BhavyaBansal26/ALPANA-SOC/sdk/software/projects/weatherstation/Readme.md

Sample project to demonstrate integration of temperature sensor and transmission of data to a website.
LM75 sensor is used to collect ambient temperature, ESP8266 module is  used to send data to thingspeak.com

Prerequisite:
1. ESP8266 is configured to baud rate 9600
2. ESP8266 is set in station mode
3. ESP8266 is configured to connect to access point.
4. A channel to receive data is configured in thingspeak.com
5. Change the API_key in the weatherstation.c
