BhavyaBansal26/ALPANA-SOC/sdk/software/examples/i2c_applns/ds3231/readme.md

sensor - lm75
peripheral - i2c

<readme to follow>
