BhavyaBansal26/ALPANA-SOC/sdk/software/projects/uart-cam/Connections/Overall.jpeg

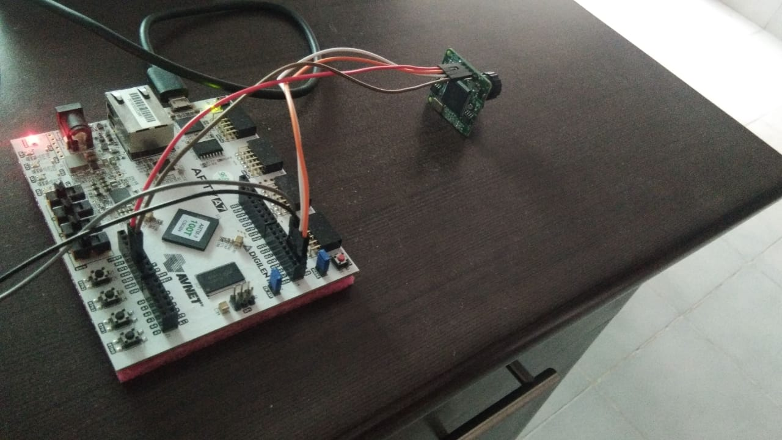
sdk/software/projects/uart-cam/Connections/Overall.jpeg
