BhavyaBansal26/ALPANA-SOC/sdk/software/projects/uart-cam/Connections/UART1&UART2.jpeg

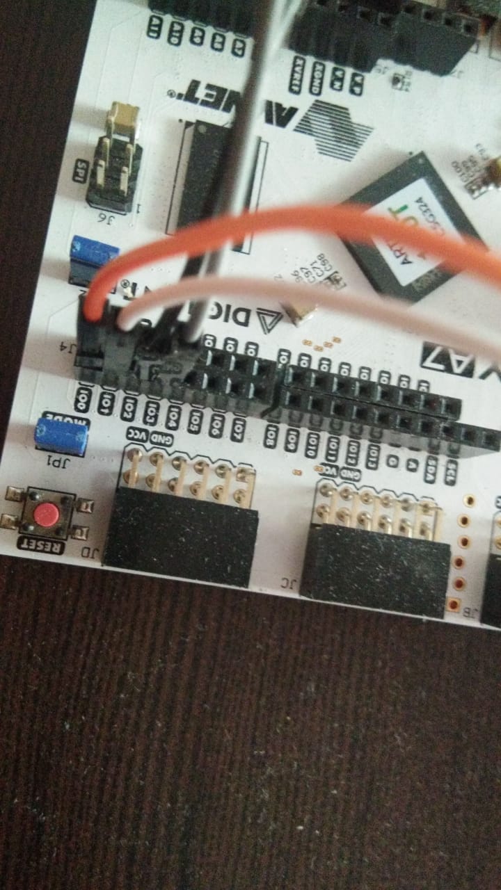
sdk/software/projects/uart-cam/Connections/UART1&UART2.jpeg
