BhavyaBansal26/ALPANA-SOC/sdk/software/projects/uart-cam/Connections/Uart_to_usb.jpeg

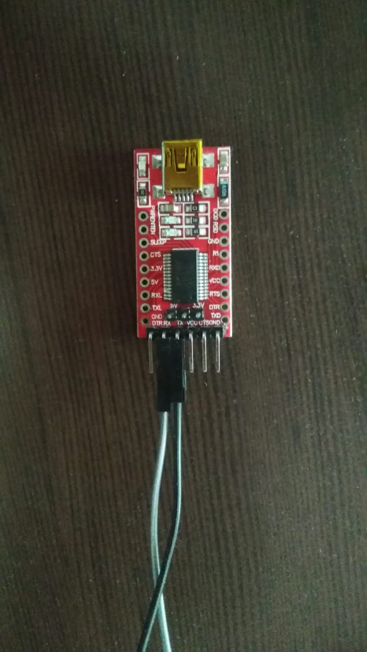
sdk/software/projects/uart-cam/Connections/Uart_to_usb.jpeg
