BhavyaBansal26/ALPANA-SOC/docs/images/esp32cam_lane_wiring.png

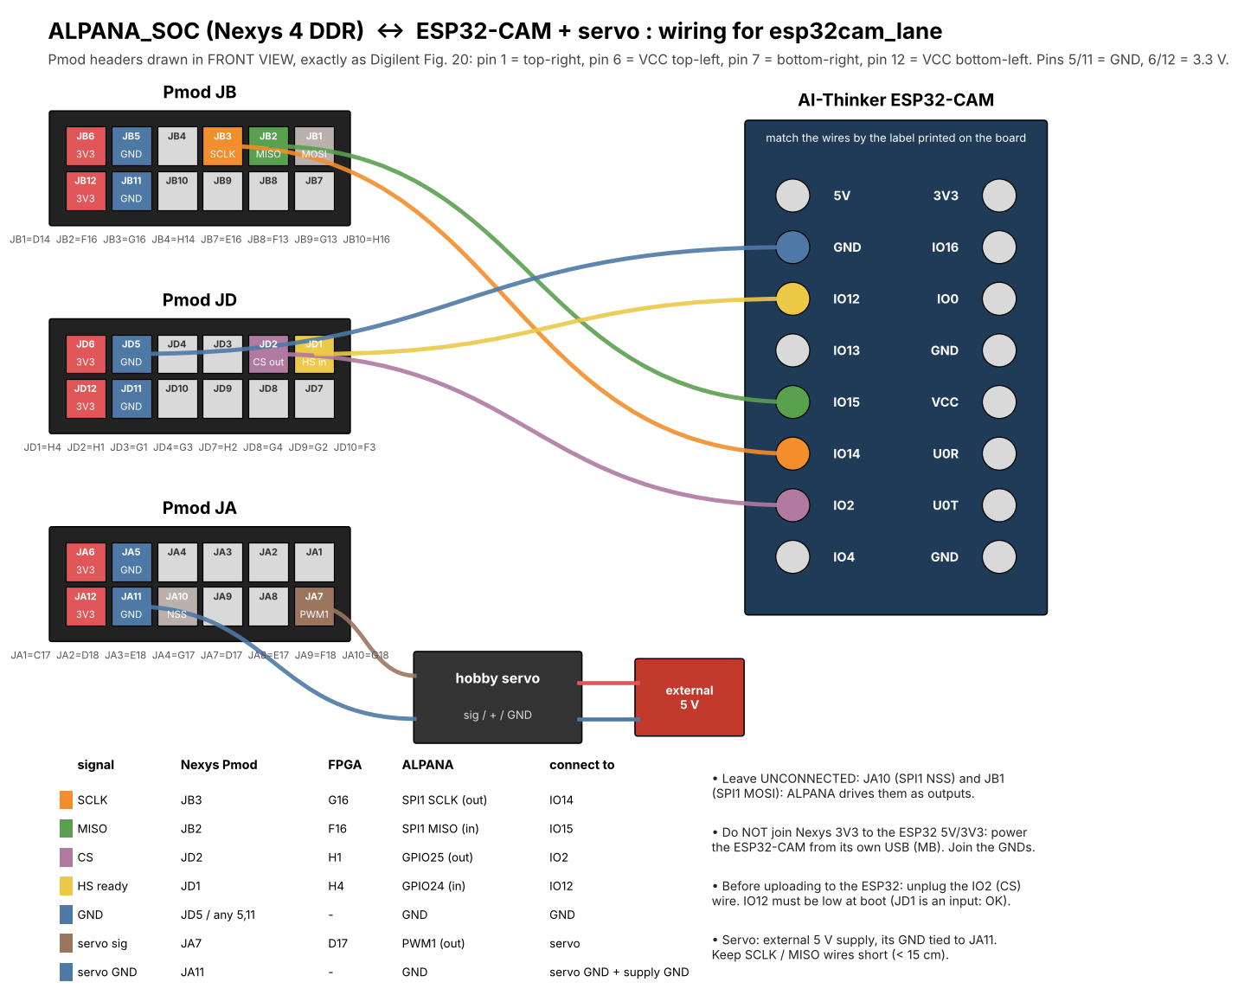
docs/images/esp32cam_lane_wiring.png
