BhavyaBansal26/ALPANA-SOC/sdk/software/examples/alpana_applns/esp32cam_lane/host/lane_test_results.png

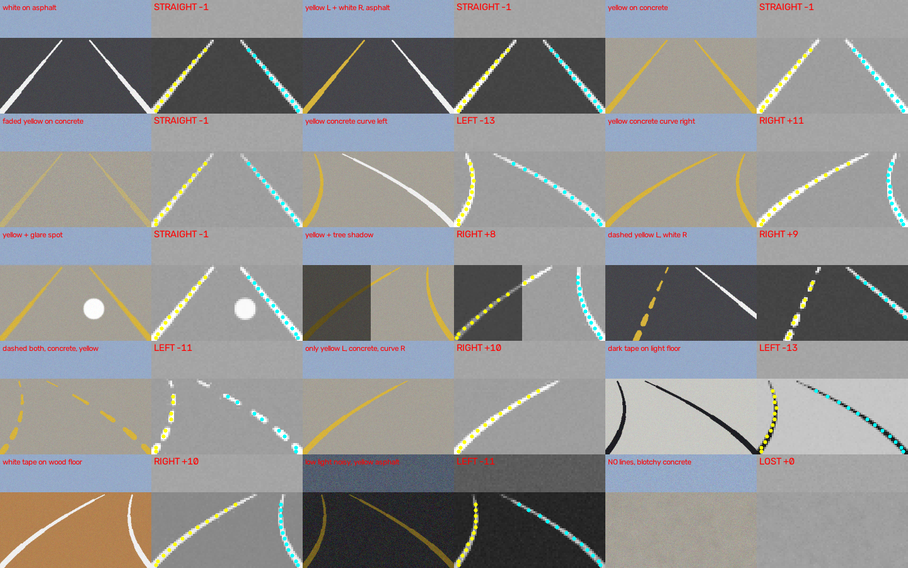
sdk/software/examples/alpana_applns/esp32cam_lane/host/lane_test_results.png
